matiu2/gridfinity_extended_openscad/TODO.md

# TODO — Breadboard-hole electronics box

Gridfinity cup, 84 x 42 x 21 mm (2x1 grid units, half-pitch base pads), no
label, no magnets/screws, with a raised inner floor drilled like a
breadboard so component legs can be pushed in.

File: `breadboard_box.scad`

## Measured facts (verified against rendered geometry, not assumed)
- Outer size 83.49 x 41.50 mm (84 x 42 less the 0.5 mm clearance),
  Z 0 .. 24.74 mm (21 mm body + 3.74 mm stacking lip).
- Foot stack 0.8 + 1.8 + 2.15 = 4.75 mm, plus the 0.7 mm cup floor
  -> stock inner floor at Z = 5.45 mm.
- The cavity just above the floor is X -38.0 .. 37.9, Y -17.0 .. 17.0.
  The wall is thicker than `wall_thickness` there because of the taper, and
  the cavity is 0.05 mm off centre in X. Both are taken from a measured
  cross-section rather than derived.
- With subPitch = 2 the feet are a 4 x 2 grid of 21 mm pads. At Z = 0.4 the
  clear channels between feet are X = 0, +/-21, +/-42 (5.61 mm) and
  Y = 0 (5.62 mm).

## Decisions
- Centre strip: 6 mm of solid deck, hole edge to hole edge, measured off the
  user's own breadboard. That puts the two innermost rows 6.9 mm apart
  centre to centre, a little under the 7.62 mm (0.3 inch) DIP standard, but
  it matches what components actually sit in. Off the 2.54 mm grid by
  design: the grid can only give 4.18 or 6.72 mm.
- Only the one lengthways strip. No strips over the joins between the feet.
- Hole depth is per hole, flat bottomed, at one of two levels: z = 1.0 where
  there is foot underneath (9.45 mm deep), z = 5.75 where there is not
  (4.7 mm deep, stopping above the gap between the feet).
  Earlier versions clipped the hole columns against a raised copy of the
  cup, which sliced any hole straddling the edge of a foot into a 0.1-0.4 mm
  sliver. Choosing a flat bottom per hole avoids that entirely; verified
  that all 300 holes come out exactly 0.9 x 0.9 mm.
- `foot_gap` is the 4.8 mm measured gap plus 0.8 mm of margin, so a hole
  landing on the edge of a pad is treated as unsupported rather than
  breaking through the corner of a foot.
- Chamfered mouths, 1.5 mm across and 0.3 mm deep, guide a component leg
  into each hole. A chamfer rather than a rounded fillet because the sloped
  wall prints without overhang.
- The holes are cut with three extrusions (deep shafts, shallow shafts, and
  the chamfer slices) rather than a pair of solids per hole. Six hundred
  primitives overflows OpenCSG, and preview (F5) then shows nothing at all
  with "CSG normalization resulted in an empty tree", while the F6 render
  stays correct. The chamfer is built as 0.2 mm slices stepping outward
  because linear_extrude's scale works about the origin, so a scaled
  extrude per hole would need 300 more primitives.

## Stage 1 — plain box  [DONE]
- [x] `breadboard_box.scad` wrapping `gridfinity_cup`
- [x] 2x1 grid units = 84 x 42 mm, height 3 units = 21 mm
- [x] `subPitch = 2` -> 21 mm base pads (half units in x + y)
- [x] label disabled; no magnets, no screws
- [x] Renders clean, STL measured at 83.49 x 41.50 x 24.74 mm

## Stage 2 — raised floor + breadboard holes  [DONE]
- [x] Inner floor raised 5 mm, to Z = 10.45
- [x] Slab trimmed by intersecting a solid (`filled_in`) cup, so it meets
      the tapered wall with no gap and no bulge
- [x] 0.9 mm square holes on a 2.54 mm pitch, continuous across the deck
- [x] Per hole flat bottoms at Z = 1.0 or Z = 5.75, all holes exactly
      0.9 x 0.9 mm, genus 0 so nothing breaks through the underside
- [x] Centre strip left solid, verified at exactly 6.00 mm
- [x] Chamfered lead-in mouths on every hole
- [x] Renders manifold, dimensions and pitch verified from the STL

## Notes for next time
- OpenSCAD resolves `include`/`use` relative to the script's own directory,
  so probe scripts must live in the project root, not in `.build/`.
- The preview renderer drops sub-pixel features: early top views appeared to
  show only 6 columns when all 28 were present. Verify counts from the STL,
  not from the image.

## Print settings assumed
- 0.4 mm nozzle, 0.2 mm layers. Clearances are chosen as whole layer
  multiples (1 mm = 5 layers). The 0.9 mm holes are narrower than the
  nozzle, so expect them to print round and a little tight, which suits
  gripping legs; raise `hole_size` to 1.0-1.1 if they close up.

## Stage 3 - sliding panels  [DONE]
- [x] All four walls slide out. `panel_walls` selects which; [0] gives just
      the front. Openings inset 6 mm from each cavity end.
- [x] Openings run from the deck right to the top of the part, THROUGH the
      stacking lip, so the rim does not bridge across and trap a panel.
      Each panel carries its own section of rim.
- [x] The panel sinks `panel_sink` (1 mm) into a recess in the floor, and
      the detents sit in that recess at the bottom edge. Earlier they were
      partway up the groove, pressing on the panel's FACE, which a 1.6 mm
      sheet just bows away from. Capturing the bottom EDGE locks it in the
      one direction the panel cannot flex.
- [x] Corner pillars 9.74 mm, keeping 6.74 mm of material between the two
      grooves that meet at each corner. The deck slab ties all four
      pillars together at the bottom.
- [x] Groove in each pillar, 3 mm deep, for the panel edges
- [x] Panel 1.6 mm thick in a 2.2 mm slot, 0.3 mm clearance per side. The
      slot now sits `panel_recess` = 1 mm in from the OUTER face, so the
      panel reads as part of the outside of the box and the corner pillar
      has room inboard to wrap back over it. (It was centred in the 3.75 mm
      wall before, 0.775 mm of skin either side.)
- [x] Detent ridges in each groove. They must be anchored ON the outboard
      face of the groove so half the cylinder is buried in the wall skin.
      Placed anywhere else they render as separate floating bodies - watch
      the body count, not just the genus.
- [x] `part` selects box / panel / both; `panel_enabled` reverts to a plain
      four-walled box
- [x] Two panel sizes: 69.30 x 1.60 x 27.99 mm for the long walls, 27.40
      wide for the short ends. Both engage 2.7 mm into each pillar.
- [x] `part` gives two views of the same model:
      - "assembled": panels seated, one connected body, 83.49 x 41.50 x
        38.74, a standard 2x1x5 gridfinity bin. This matters because the bin
        lives in a 5-unit carry box whose roof AND floor have gridfinity lip
        plugins gripping it.
        NOTE: a cross-section at z = 38 gives EIGHT loops, not one - four
        corners plus each panel's rim section. That is correct and expected:
        the panels are deliberately separate bodies with 0.3 mm clearance,
        so in the model the lip reads as islands. Printed and assembled the
        profile closes up. An earlier note here claimed one loop; that was
        measured before the panels became separate bodies and was wrong.
      - "print": each panel translated 25 mm out from its wall, giving five
        disconnected bodies. STL carries no part names, so separation is the
        only way a slicer can split the file into objects.
- [x] Deck and hole grid untouched: the opening starts at the deck, so no
      holes are cut and the deck keeps its support

- [x] Corner pillars form the groove themselves, rather than the wall
      holding the panel and separate huggers pressing on it:
      - The pillar spans `groove_depth + hug_size` = 6 mm along the wall, so
        it covers the run of slot cut into the corner AND 3 mm of solid
        material past the end of it. Sizing it to the slot alone let the
        slot cut the whole pillar away, leaving only the 1 mm outboard skin
        and no channel - caught by ray-casting the wall section, where the
        corner read as two 1 mm skins with a void between them.
      - It is added BEFORE `panel_voids()` so the slot cuts through it. Added
        after, it just fills the slot back in.
      - Above `body_top` only the part beyond the rim cut continues, up to
        the lip. The full pillar cannot go there: the panel's rim section
        has to reach the outer surface through that band.
- [x] Verified by ray-casting rather than by eye: solid 4.20 mm corner
      outboard of the opening, a 1 mm / 2.2 mm / 1 mm channel across the
      pillar, and an open window between them.
- [x] The four corner squares filled solid (`panel_corner_fill`). Each
      wall's pillar reached its own end of the cavity and stopped, leaving
      the square where two walls meet hollow - the slot is cut straight
      through it on its way into the pillar and nothing filled in behind.
      Visible from above as a void between the outer skin and the
      neighbouring wall's pillar; measured as a 2.75 mm gap at x = -38.5.
      - Added AFTER `panel_voids()`, unlike the pillars. Before the cut the
        slot would carve it straight out again. Safe because the corner
        square is outside every panel's travel.
      - Built from explicit outer limits, not cavity + wall_thickness: the
        cavity is asymmetric in X (-38.00 vs +37.90), so a fixed-size block
        grown from each corner overshoots on one side.
      - Inboard faces pulled back 0.01 mm so they do not land exactly on the
        raised floor's cavity boundary. Coincident faces there made CGAL
        emit a degenerate zero-thickness shell - a stray 10-triangle body
        flat in the y = 17 plane, which showed as genus -1 and a second
        body while looking perfectly fine in every render.

- [x] Lead-in chamfer at the top of the channel, so the panel can be aimed
      roughly and still find the slot. Coming down from above the panel met
      nothing until body_top and then hit a square edge - a 2.2 mm blind
      target. The mouth now opens to 3.00 mm and narrows back to 2.20 mm
      over 2.5 mm of height, so there is 1.4 mm of slop to aim into rather
      than 0.6 mm.
      - `panel_lead_in` is 0.4 mm per side, NOT more. The outboard skin and
        the inboard wrap are both 1 mm and the chamfer thins them at the
        mouth; 0.4 leaves 0.6 mm, still over one 0.4 mm extrusion width.
        0.8 would leave 0.2 mm and the slicer would drop it entirely.
      - Runs the whole length of the slot, pillars included: the pillars are
        where the panel is tightest, so that is where the funnel earns its
        keep. Verified present at x = -34.9 through +34.8.

- [x] Panel clearance cut from 0.3 to 0.1 mm per side, and split from the
      modelling gap that was riding on the same parameter.
      - The panel is printed FLAT, so its 1.6 mm is 8 layers of 0.2 and
        comes out accurate. The slot is an XY feature on a box printed
        upright - the looser axis - so the clearance belongs there, not
        spread across both.
      - `xy_hole_compensation = 0.2`, set for the 0.9 mm breadboard holes,
        widens this slot too. So 0.3 modelled was landing near 0.4 per side
        printed: 0.8 mm of total slop on a 1.6 mm panel, which rattles.
        0.1 modelled lands near 0.2 per side, halving it to 0.4 mm.
      - `panel_model_gap` (0.15) now does the job of keeping the panel a
        separate body from the box in the render. It was `panel_clearance`
        doing double duty, so tightening the fit would have fused the two
        into one body and broken the print layout. Verified still five
        bodies at 0.1 mm clearance.
      - If the panels bind, raise `panel_clearance`; printed fit is roughly
        that value plus 0.1.

- [x] Detents turned OFF (`detent_size = 0`). PRINTED AND CONFIRMED: with
      them in, the panel would not go into the groove at all. They were
      sized when `panel_clearance` was 0.3 mm per side and the panel could
      rattle; at 0.1 mm - nearer 0.2 printed, after the slicer's hole
      compensation widens the slot - friction plus the pillars' 1 mm wrap
      already hold the panel. The code is kept and guarded on
      `detent_size > 0`, so setting it back to 0.4 restores them.
      - The matching notches in the panel are guarded too, so the panel is a
        plain flat sheet rather than carrying scallops for absent bumps.
        Verified: below `body_top` the panel has exactly two Y faces,
        1.60 mm apart. The stepped values above it are the rim's lip
        profile and belong there.
      - The "assembled" view now renders as FIVE bodies, not one. That is
        correct: the detents were the only thing touching, and without them
        the parts are genuinely separate. Panel still seats at the right
        place - y -19.65..-18.05 inside a slot of -19.75..-17.95.

- [x] Bigger hole mouths: `mouth_size` 1.5 -> 2.0, so the lead-in goes from
      0.30 to 0.55 mm. This is near the ceiling: at 45 degrees a 1 mm
      lead-in would need a 2.9 mm mouth, wider than the 2.54 mm pitch, so
      the mouths would merge and the deck between holes would vanish. 2.0
      leaves 0.54 mm of flat deck, just over one extrusion.
- [x] Holes taper 0.9 -> 0.6 mm so a leg wedges and is held. Verified
      through the depth: 0.9 at the deck, then 0.88 / 0.81 / 0.74 / 0.67 /
      0.62 going down. The top `deck_skin` (1 mm) stays a straight 0.9 mm
      shaft so a leg enters without resistance.
      - A HOLE is empty space, so the 0.4 mm nozzle does not limit it. The
        limit is the SOLID between features, and narrowing the hole makes
        that thicker, i.e. easier to print, not harder.
      - The taper must be built one hole at a time: `linear_extrude(scale=)`
        scales about the ORIGIN, so extruding the whole grid with a scale
        flings the copies outwards. Wrapped in `render()` so the per-hole
        primitives do not overflow the preview renderer.
- [x] Deck cut into long parallel RIBS by continuous slots (`rib_slot`),
      one in each gap between hole rows, running the length of the box.
      - This replaced a per-hole pocket scheme. The pockets barely flexed:
        every wall was welded to its neighbours at each crossing in both
        axes, so it was caged within one 2.54 mm cell. A rib is anchored
        only at its two ends and bows over its full ~70 mm. Deflection goes
        as span cubed, so the rib is ~20,000x more compliant for the same
        wall thickness. The user proposed this; it is much better than what
        I had built.
      - 0.8 mm slots leave 1.74 mm ribs with 0.42 mm beside each hole.
      - Slots stay buried under `deck_skin`, so from above the deck still
        reads as a solid surface; the skin bridges each slot.
      - Rows either side of the undrilled centre strip are more than a pitch
        apart, so no slot is placed there and the strip stays solid -
        verified as an 8.64 mm solid block in cross-section.
      - Verified: 5 real parts, box one connected solid, ribs 1.74 mm at
        z=7.7, holes still taper 0.9 -> 0.62.
      - Saving is ~1.4 g. Modest; the flex is the point, not the filament.

## An earlier attempt that broke the part
Removing everything between per-hole walls - the obvious reading of
"hollow it out" - makes every wall an island, because the walls cannot
reach each other without being a full pitch wide (i.e. solid deck again).
The whole deck then drops out as a loose 73.9 x 32.0 x 3.4 mm slab. It
rendered without error and looked correct; only the body count caught it.
Check `bodies=` after any change that removes interior material.

## Note on the "hollow corner" above z = 35
Not a defect - it is the stacking lip's own recess, the same on a stock
gridfinity cup. Measured side by side at x = -38.5: stock gives 2.80 / 2.01
/ 1.37 mm at z = 35 / 36 / 38 and this box gives 2.76 / 1.94 / 1.47. Below
the lip our corner is 9.72 mm of solid material where stock is 0.87. Filling
it would break stacking and stop the carry box's roof plugins seating.

When checking a corner, scan the FULL height. Measuring only at z = 20 says
nothing about the lip section, which is the part that looks hollow.

## Possible follow-ups (not requested)
- Chamfer the hole mouths slightly so legs self-centre when pushed in.
- A matching lid, or a version with the channel running the short way.
