matiu2/gridfinity_extended_openscad/(commit log)

2026-09-21 Add breadboard-hole gridfinity box for electronics storage
    A 2x1 gridfinity cup (83.5 x 41.5 x 24.74 mm) with half-pitch base pads,
    no label and no magnet or screw holes, whose inner floor is raised 5 mm and
    drilled on a 2.54 mm grid so component legs can be pushed in.
    28 columns x 10 rows of 0.9 mm square holes, 8.45 mm deep. The two innermost
    rows are 7.62 mm apart, the 0.3 inch DIP pin spacing, straddling a 5 mm
    centre groove that runs the length of the box.
    The groove sits in the Y = 0 channel between the two rows of feet, measured
    at 5.6 mm wide, which is the one place a deep cut meets no foot. Hole depth
    is 8.45 mm rather than the nominal 10 mm so that 2 mm of solid base remains
    abov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
    [breadboard_box.scad]
2026-09-21 Leave the breadboard centre strip solid instead of a trench
    The middle band is still undrilled, so the two innermost hole rows stay
    7.62 mm apart for DIP packages, but it is no longer cut away. Removes the
    5 mm groove and the channel_width parameter along with it.
    [breadboard_box.scad]
2026-09-21 Stop holes 1mm above whatever is below, not at one fixed depth
    In the three lengthways gaps between the feet there is no foot under the
    floor, so a uniform 8.45 mm hole broke through the underside.
    Each hole is now clipped against a copy of the cup raised by the clearance,
    which stops it 1 mm (5 layers at 0.2 mm) above whatever solid lies beneath
    that particular hole. Over a foot that gives 9.45 mm of depth, over a gap
    5.45 mm. No hardcoded foot positions, so it follows the base if the grid or
    pitch changes.
    [breadboard_box.scad]
2026-09-21 Leave solid strips over the joins between the feet
    Adds undrilled strips across the short way at X = 0, +/-21, matching the
    lengthways strip down the middle. Those are the bands with no foot beneath
    them, so every remaining hole now bottoms at z = 1 with the full 9.45 mm of
    depth and none are shallow.
    strip_width is the measured 4.8 mm gap between feet at the hole-bottom
    level, not a standard. strip_margin keeps a hole off the edge of a foot,
    where the depth clip previously sliced it into 0.1-0.4 mm slivers; all 220
    holes now come out exactly 0.9 mm square.
    The hole grid is centred on the part rather than the cavity, which is
    0.05 mm off in X and was making the strips asymmetric.
    Co-Autho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
    [breadboard_box.scad]
2026-09-21 Set the centre strip to a measured 6mm and add lead-in chamfers
    The strip is now 6 mm of solid deck between hole edges, measured off a real
    breadboard, rather than the 6.72 mm the 2.54 mm grid happened to give. That
    puts the innermost rows 6.9 mm apart, slightly under the 0.3 inch DIP
    figure, but it is what components actually sit in.
    Drops the strips over the joins between the feet, so the grid runs right
    across the deck. Holes with no foot under them are simply shallower.
    Depth is now chosen per hole, flat bottomed, rather than by clipping the
    columns against a raised copy of the cup. Clipping sliced any hole on the
    edge of a foot into a 0.1-0.4 mm sliver; all 300 holes now come out exac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
    [breadboard_box.scad]
2026-09-21 Cut the holes with three extrusions so preview stops emptying out
    Six hundred primitives, a shaft and a scaled chamfer per hole, overflowed
    OpenCSG: preview (F5) gave "CSG normalization resulted in an empty tree" and
    showed nothing, though the F6 render was correct throughout.
    Holes only ever take one of two bottom levels, so the shafts now go in two
    extrusions over a 2D union each. The chamfer is a stack of 0.2 mm slices
    stepping outward, matching what the slicer produces anyway, because
    linear_extrude scales about the origin and a scaled extrude per hole would
    have put the primitive count straight back.
    Geometry unchanged: 220 deep and 80 shallow holes, all exactly 0.9 mm
    square, centre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
    [breadboard_box.scad]
2026-09-22 Make the bin 5 units tall
    35 mm of body, 38.74 mm including the stacking lip. The hole deck stays at
    Z = 10.45 since it is set by the feet, so the extra height is all clear
    space above the holes: 24.55 mm rather than 10.55 mm.
    Everything else is unchanged and re-verified: 300 holes at 0.9 mm square,
    6.000 mm centre strip, genus 0.
    [breadboard_box.scad]
2026-09-22 Add a sliding front panel in place of one long wall
    One long wall becomes an opening with a panel that slides straight up and
    out, running in grooves cut into the corner pillars either side. The opening
    starts at the deck, so the hole grid and its support are untouched.
    The slot is centred in the 3.75 mm wall, 2.2 mm wide for a 1.6 mm panel with
    0.3 mm clearance per side - generous because PETG prints fat and a sliding
    fit that is too tight is unusable. Corner pillars stay 9.74 mm wide and the
    panel engages 2.7 mm into each.
    Detent ridges near the bottom of each groove hold the panel in when the box
    is tipped. They are anchored on the outboard face of the groove so half of
    each cylinder is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
    [breadboard_box.scad]
2026-09-22 Make all four walls slide out, and take the rim with them
    The openings now run from the deck right to the top of the part, through the
    stacking lip. Previously they stopped at the body top, so the rim bridged
    across each opening and the panel could not slide up past it. Each panel
    carries its own section of rim instead.
    With the rim gone from the openings nothing joined the corner pillars at the
    top, so each groove gets a second detent just under the rim to capture the
    panel there. The deck slab already tied the pillars together at the bottom.
    All four walls are panels by default; `panel_walls` selects which. Two panel
    sizes result, 69.30 mm for the long walls and 27.40 mm for the short en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
    [breadboard_box.scad]
2026-09-22 Explode the panels clear of the box so a slicer can split them
    Left in their slots the panels touch the box at the corners, so the STL
    imports as a single connected body and cannot be split into objects. STL
    carries no part names, so separation is the only signal a slicer has.
    Each panel is now translated 25 mm straight out from its own wall in the
    "both" layout, giving five disconnected bodies: the box and four panels.
    [breadboard_box.scad]
2026-09-22 Sink the panels into a floor recess and lock them at the bottom edge
    The detents were partway up the groove, bearing on the panel's flat face.
    A 1.6 mm sheet bows out of plane easily, so that would have popped free
    under light load rather than holding.
    The slot now runs 1 mm below the deck into a recess in the floor, the panel
    drops into it, and the detents sit in that recess at the panel's bottom
    edge. The panel is captured by its edge, which it cannot flex away from.
    Panels are 28.99 mm tall for the long walls and 28.62 for the short, both
    bottoming at Z 9.75 against a deck at 10.45. Still five separate bodies.
    [breadboard_box.scad]
2026-09-22 Add an assembled view alongside the exploded print layout
    The bin is stored in a 5-unit gridfinity carry box whose roof and floor both
    have lip plugins, so the stacking lip has to read as continuous with the
    panels seated. The exploded layout was only ever a printing convenience.
    `part` now selects "assembled" (panels in place, one body, a standard
    2x1x5 bin) or "print" (panels moved clear, five bodies for the slicer to
    split). Verified the assembled lip is a single closed loop in cross-section
    at z = 38.
    [breadboard_box.scad]
2026-09-22 Re-add detents up the groove alongside the floor recess
    Three per groove now: one in the floor recess catching the panel's bottom
    edge, which is what actually locks it, plus two spaced up the groove at 40%
    and 75% of the panel height to stop a long panel bowing out in the middle.
    [breadboard_box.scad]
2026-09-22 Add hugging pillars at the panel ends
    Square 3 mm pillars stand inboard of the slot at each end of a panel,
    reaching 1 mm past the panel's inner face so they hug it against the outer
    wall of the slot. Unlike a detent they run the panel's full height, so they
    hold it along its length rather than at a point, and nothing needs to be
    grooved: the panel stays a plain 1.6 mm sheet.
    This is what a rail would have done, without the geometry problem a rail
    has here. A rail puts the groove in the panel, and a 1.6 mm panel cannot
    host a 1.6 mm groove; making the panel thick enough (3.2 mm) then leaves it
    wider than the 3.75 mm wall once clearance is added.
    The pillars stop at the body top rather than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
    [breadboard_box.scad]
2026-09-22 Make the corner pillars form the panel groove
    The panel was held by a slot centred in the wall, with separate pillars
    standing inboard of it pressing the panel against the outer skin. This
    turns that around: the slot moves out to sit 1 mm inside the box's outer
    face, and the corner pillar is fattened to wrap around the panel on three
    sides. The corner holds the groove, rather than the wall holding the panel.
    The panel therefore sits 1 mm inside the outer surface rather than centred
    in the wall. That recess is the outboard half of the channel; without it
    the slot would break out through the side of the box.
    Two things this got wrong on the way, both caught by ray-casting the wall
    cross-sect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
    [breadboard_box.scad]
2026-09-22 Fill the hollow corner squares solid
    Each wall's pillar reached its own end of the cavity and stopped, so the
    square where two walls meet was left hollow: the slot for one wall is cut
    straight through that square on its way into the pillar, and nothing filled
    in behind it. From above it read as a void between the outer skin and the
    neighbouring wall's pillar - a 2.75 mm gap, measured by ray-casting the
    section at x = -38.5.
    panel_corner_fill() fills all four, clipped to the cup so it follows the
    rounded outside corner, from the floor recess up through the lip. It is
    outside every panel's travel and outside the hole grid, so it costs nothing
    but the corner volume, and it ties each corner's t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
    [breadboard_box.scad]
2026-09-22 Flare the top of the panel channel into a lead-in
    Coming down from above, a panel met nothing at all until body_top and then
    hit a square edge where the 2.2 mm slot starts - a blind target that had to
    be lined up by eye. The mouth now opens to 3.00 mm and narrows back to the
    slot proper over 2.5 mm of height, so there is 1.4 mm of slop to aim into
    instead of 0.6 mm, and a panel offered up roughly square is walked into
    place.
    panel_lead_in is 0.4 mm per side and deliberately not more. The outboard
    skin and the inboard wrap are both 1 mm, and the chamfer thins them at the
    mouth: 0.4 leaves 0.6 mm, still wider than one 0.4 mm extrusion. The 0.8 mm
    this started at would have left 0.2 mm, under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
    [breadboard_box.scad]
2026-09-22 Tighten the panel clearance to 0.1 mm and split off the modelling gap
    The panels are printed flat, so their 1.6 mm thickness is 8 layers of 0.2
    and comes out accurate. The slot is an XY feature on a box printed upright,
    which is the looser axis, so the clearance belongs there rather than being
    spread generously across both.
    More to the point, xy_hole_compensation = 0.2 - set for the 0.9 mm
    breadboard holes - widens this slot as well. The 0.3 mm clearance was
    therefore landing near 0.4 mm per side printed: 0.8 mm of total slop on a
    1.6 mm panel, enough to rattle. At 0.1 modelled it lands near 0.2 per side,
    halving the slop to 0.4 mm.
    panel_clearance was doing double duty: sizing the slot AN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
    [breadboard_box.scad]
2026-09-23 Turn the detents off; the printed panel would not go in past them
    Printed and confirmed: with the detents in, the panel would not enter the
    groove at all. They were sized back when panel_clearance was 0.3 mm per
    side and a panel could rattle in its slot. At 0.1 mm - nearer 0.2 printed,
    once the slicer's hole compensation has widened the slot - friction against
    the slot plus the corner pillars' 1 mm wrap already hold the panel, so the
    bumps only got in the way.
    detent_size is now 0 rather than the code being deleted, and both the
    detents and the matching notches in the panel are guarded on it, so setting
    it back to 0.4 brings them back if a panel ever works loose.
    Guarding the notches too m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
    [breadboard_box.scad]
2026-09-23 Taper the holes for grip, widen the mouths, and hollow the deck
    Three changes to make components stay put when the bin is tipped.
    Mouths go from 1.5 to 2.0 mm, taking the lead-in from 0.30 to 0.55 mm. That
    is near the ceiling rather than an arbitrary choice: at 45 degrees a 1 mm
    lead-in needs a 2.9 mm mouth, wider than the 2.54 mm pitch, so the mouths
    would merge and the deck between holes would disappear. 2.0 leaves 0.54 mm
    of flat deck, just over one extrusion.
    Holes now taper from 0.9 mm at the deck to 0.6 at the bottom, so a leg
    wedges rather than sliding straight through. The top millimetre stays a
    straight 0.9 shaft so the leg enters without resistance. Verified through
    the depth: 0.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
    [breadboard_box.scad]
2026-09-23 Cut the deck into long ribs instead of per-hole pockets
    The pocket scheme barely flexed, and the reason is structural: each pocket
    wall was welded to its neighbours at every crossing in both axes, so it was
    caged within a 2.54 mm cell. Continuous slots between the hole rows leave
    long ribs instead, each carrying one row and anchored only at its two ends
    against the cavity walls. A rib bows over its full ~70 mm span.
    Deflection goes as the cube of the span, so the rib is roughly 20,000 times
    more compliant than a caged cell of the same wall thickness. That is the
    difference between technically flexing and actually springing, which is the
    whole point of the feature. Credit to the user for pro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
    [breadboard_box.scad]
2026-09-23 Add a splitter that cuts the rib band out as its own part
    The bands only act as springs if the slicer leaves them as thin beams. At
    two wall loops a 1.74 mm rib fills solid wall-to-wall and barely flexes,
    which defeats the point of cutting the slots in the first place. Giving just
    that band one wall loop and no infill keeps it thin, and everywhere else
    keeps normal settings.
    split_rib_band.scad emits the box as two pieces, cut at the band the slots
    occupy (z 6.05 .. 9.45, matching deck_hollow):
    openscad -o rib_band.stl -D 'piece="band"' split_rib_band.scad
    openscad -o box_rest.stl -D 'piece="rest"' split_rib_band.scad
    Both are cut against the same volume, one by intersection and one b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
    [split_rib_band.scad]
2026-09-23 Limit the rib band part to the drilled area only
    The band was taking a full-width slice of the box, which put the outer
    walls and the undrilled centre strip into the low-wall, no-infill part.
    Neither belongs there: the outer walls carry the whole box and need their
    full wall count, and the centre strip is the column holding up the deck
    above it, so it wants solid infill rather than none.
    The band is now two blocks, one either side of the strip, bounded by the
    outermost hole edges (X +/-37.28, Y 3.00..14.06) plus a 0.3 mm margin so
    the cut lands in solid material rather than clipping a hole wall.
    Verified by cross-section at z=7.7: the band holds only the six 1.74 mm
    ribs and the two 1.62 m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
    [split_rib_band.scad]
2026-09-24 Narrow the rib slots so hole compensation has room to work
    The holes printed with only ~0.1-0.2 mm of opening, and wall count made no
    difference, which ruled out the walls spreading. The cause is simpler: the
    slicer puts a full perimeter bead around every hole, and a 0.42 mm bead
    inside a 0.9 mm square leaves ~0.06 mm of actual opening. The slicer was
    doing exactly what it was asked.
    xy_hole_compensation is the right tool for that - it shrinks the bead
    inward rather than enlarging a void that will just get the same treatment -
    but at 0.8 mm slots it took the material beside each hole from 0.42 to
    0.32 mm and broke the ribs into posts. The two features were competing for
    the same material.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
    [breadboard_box.scad]
2026-09-24 Give up on the spring ribs; taper alone does the gripping
    Printed, the ribs did work mechanically - components went in with more
    resistance and stayed put noticeably better. But the solid deck skin above
    them had nothing to anchor to and printed loose strands criss-crossing the
    holes, first in the corners and then, with 15% infill in the band, more in
    the middle. Clearing them meant wiggling a needle into every affected hole.
    That is more post-processing than the extra grip is worth.
    rib_slot = 0 restores a solid deck. The grip now comes from the taper alone,
    which is the mechanism that never depended on anything fragile: the hole
    narrows as the leg goes in and the leg wedges.
    deck_skin al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
    [breadboard_box.scad]
